Anandkadpe/X--Y-Pen-Plotter-/Photos/IMG_3834.jpg

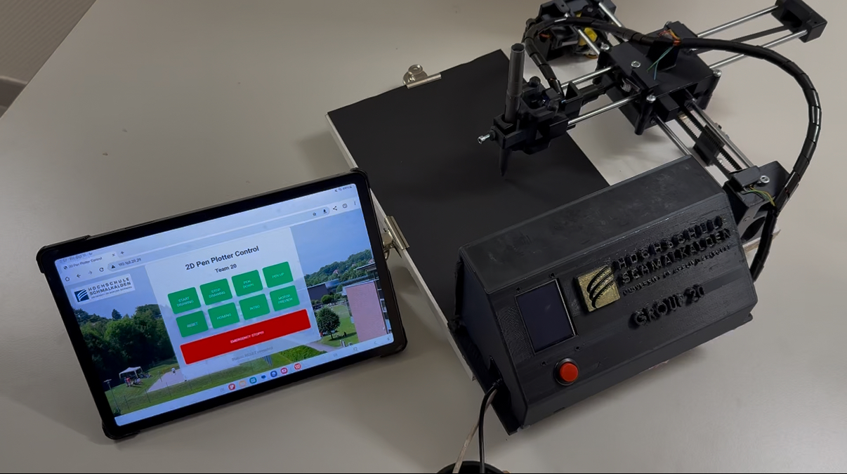
Photos/IMG_3834.jpg
